hanebuechenes/synapsMEGAVCO/Hardware/production/V0.1/bom.csv

Designator | Footprint | Quantity | Value | LCSC Part #
C10, C5 | CP_Elec_6.3x7.7 | 2 | 100uF 25V
C11, C6, C_IN2 | 0805 | 3 | 10uF 25V X7R
C12, C13, C14, C17, C18, C19, C4, C7, C9, C_BOOT1, C_IN1 | 0603 | 11 | 100nF 50V X7R
C15, C16 | 0603 | 2 | 22pF
C20, C22 | 0603 | 2 | 1nF
C21, C23, C26 | 0603 | 3 | 1uF
C24, C25 | 0603 | 2 | 100nF
C_OUT1 | 0805 | 1 | 22uF 10V X5R/X7R
D1 | D_SMA | 1 | B340A
D10, D4, D5, D6, D9 | D_SOD-123 | 5 | D_Zener
D2, D3 | D_SMA | 2 | MBRA140T3G
D7, D8 | led-3mm | 2 | LED
F1, F2 | 1210 | 2 | Polyfuse
FB1, FB2 | 0603 | 2 | 120R@100MHz 2A
J1 | PinHeader_2x05_P2.54mm_Vertical | 1 | Eurorack Header
J10 | PJ301M-12 | 1 | SUB_OUT
J2 | PinHeader_2x03_P2.54mm_Vertical | 1 | ISP
J3 | PJ301M-12 | 1 | AudioOut_L
J4 | PJ301M-12 | 1 | AudioOut_R
J5 | PJ301M-12 | 1 | CV_IN
J6 | PJ301M-12 | 1 | GATE_IN
J7 | PJ301M-12 | 1 | CLOCK_IN
J8 | PJ301M-12 | 1 | SYNC_IN
J9 | PJ301M-12 | 1 | MORPH_CV
L1 | L_Coilcraft_XxL4030 | 1 | 10uH bis 15uH >1A
R1 | 0603 | 1 | 47k 1%
R10, R17, R18, R21, R6, R8, R9 | 0603 | 7 | 1k 1%
R11, R7 | RES-TH_RK09K1130A70 | 2 | RK09K1130A70 | C351173
R12, R13, R14, R15, R16, R19, R20, R5 | 0603 | 8 | 10k 1%
R2 | 0603 | 1 | 9,1k 1%
SW1 | SW_PUSH_6mm | 1 | SW_Push
U1 | SOT-23-6_L2.9-W1.6-P0.95-LS2.8-BL | 1 | TPS54302DDCR_C311983 | C311983
U3 | TQFP-32_7x7mm_P0.8mm | 1 | ATmega328P-A
U4 | SOIC-14_3.9x8.7mm_P1.27mm | 1 | MCP4922
U6 | SOIC-14_L8.7-W3.9-P1.27-LS6.0-BL | 1 | TL074
Y2 | Crystal_HC49-U_Vertical | 1 | 16MHz
