hanebuechenes/synapsMEGAVCO/Hardware/synapsMEGAVCO.kicad_pcb

## KiCad design Hardware/synapsMEGAVCO.kicad_pcb (2026-11-06)

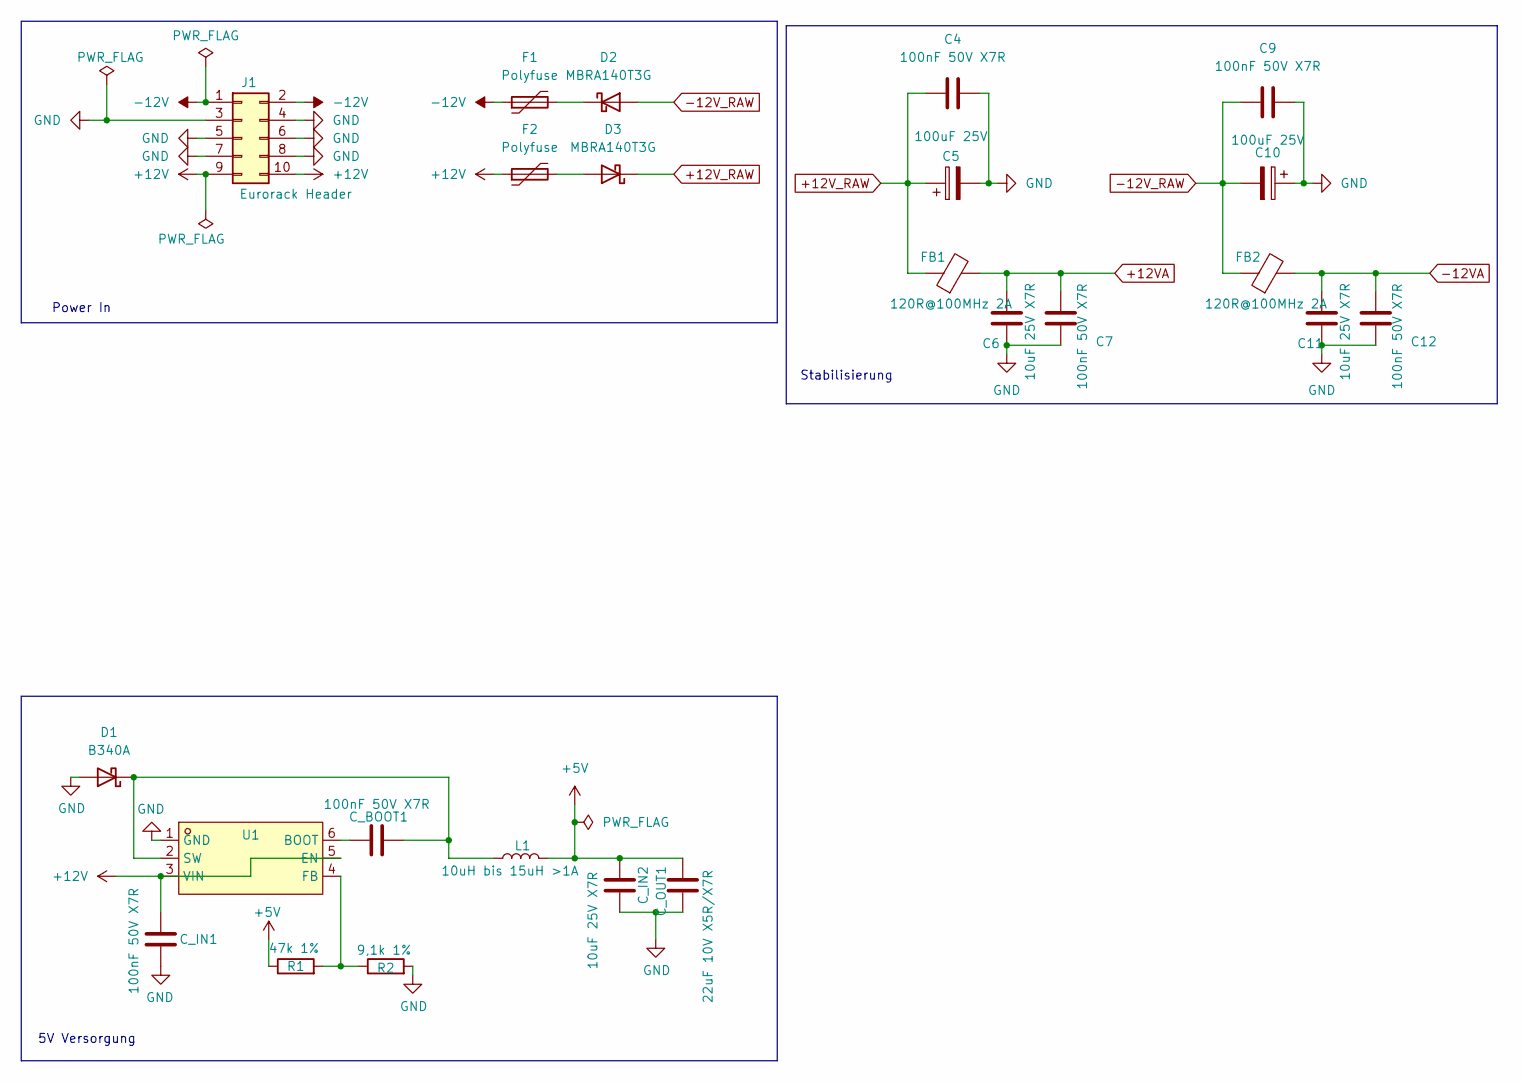
[picture p1: schematic eurorackpower.kicad_sch]

Parts:
C4, C7, C9, C12: 100nF 50V X7R; C_0603_1608Metric_Pad1.08x0.95mm_HandSolder
C5, C10: 100uF 25V; CP_Elec_6.3x7.7
C6, C11: 10uF 25V X7R; C_0805_2012Metric_Pad1.18x1.45mm_HandSolder
C_BOOT1: 100nF 50V X7R; C_0603_1608Metric_Pad1.08x0.95mm_HandSolder
C_IN1: 100nF 50V X7R; C_0603_1608Metric_Pad1.08x0.95mm_HandSolder
C_IN2: 10uF 25V X7R; C_0805_2012Metric_Pad1.18x1.45mm_HandSolder
C_OUT1: 22uF 10V X5R/X7R; C_0805_2012Metric_Pad1.18x1.45mm_HandSolder
D1: B340A; D_SMA
D2, D3: MBRA140T3G; D_SMA
F1, F2: Polyfuse; Fuse_1210_3225Metric
FB1, FB2: 120R@100MHz 2A; L_0603_1608Metric_Pad1.05x0.95mm_HandSolder
J1: Eurorack Header; PinHeader_2x05_P2.54mm_Vertical
L1: 10uH bis 15uH >1A; L_Coilcraft_XxL4030
R1: 47k 1%; R_0603_1608Metric_Pad0.98x0.95mm_HandSolder
R2: 9,1k 1%; R_0603_1608Metric_Pad0.98x0.95mm_HandSolder
U1: TPS54302DDCR_C311983; SOT-23-6_L2.9-W1.6-P0.95-LS2.8-BL; MPN TPS54302DDCR; LCSC Part C311983

Connections:
+5V: C_IN2.1, C_OUT1.1, L1.2, R1.1; also elsewhere on the board
+12V: C_IN1.1, F2.1, J1.9, J1.10, U1.3 (VIN), U1.5 (EN)
+12VA: C6.1, C7.1, FB1.2; also elsewhere on the board
+12V_RAW: C4.1, C5.1, D3.1 (K), FB1.1
-12V: F1.1, J1.1, J1.2
-12VA: C11.1, C12.1, FB2.2; also elsewhere on the board
-12V_RAW: C9.1, C10.2, D2.2 (A), FB2.1
GND: C4.2, C5.2, C6.2, C7.2, C9.2, C10.1, C11.2, C12.2, C_IN1.2, C_IN2.2, C_OUT1.2, D1.2 (A), J1.3, J1.4, J1.5, J1.6, J1.7, J1.8, R2.2, U1.1 (GND); also elsewhere on the board
unnamed: C_BOOT1.2, D1.1 (K), L1.1, U1.2 (SW)
unnamed: D2.1 (K), F1.2
unnamed: D3.2 (A), F2.2
unnamed: C_BOOT1.1, U1.6 (BOOT)
unnamed: R1.2, R2.1, U1.4 (FB)

Notes on the sheet:
5V Versorgung
Power In
Stabilisierung

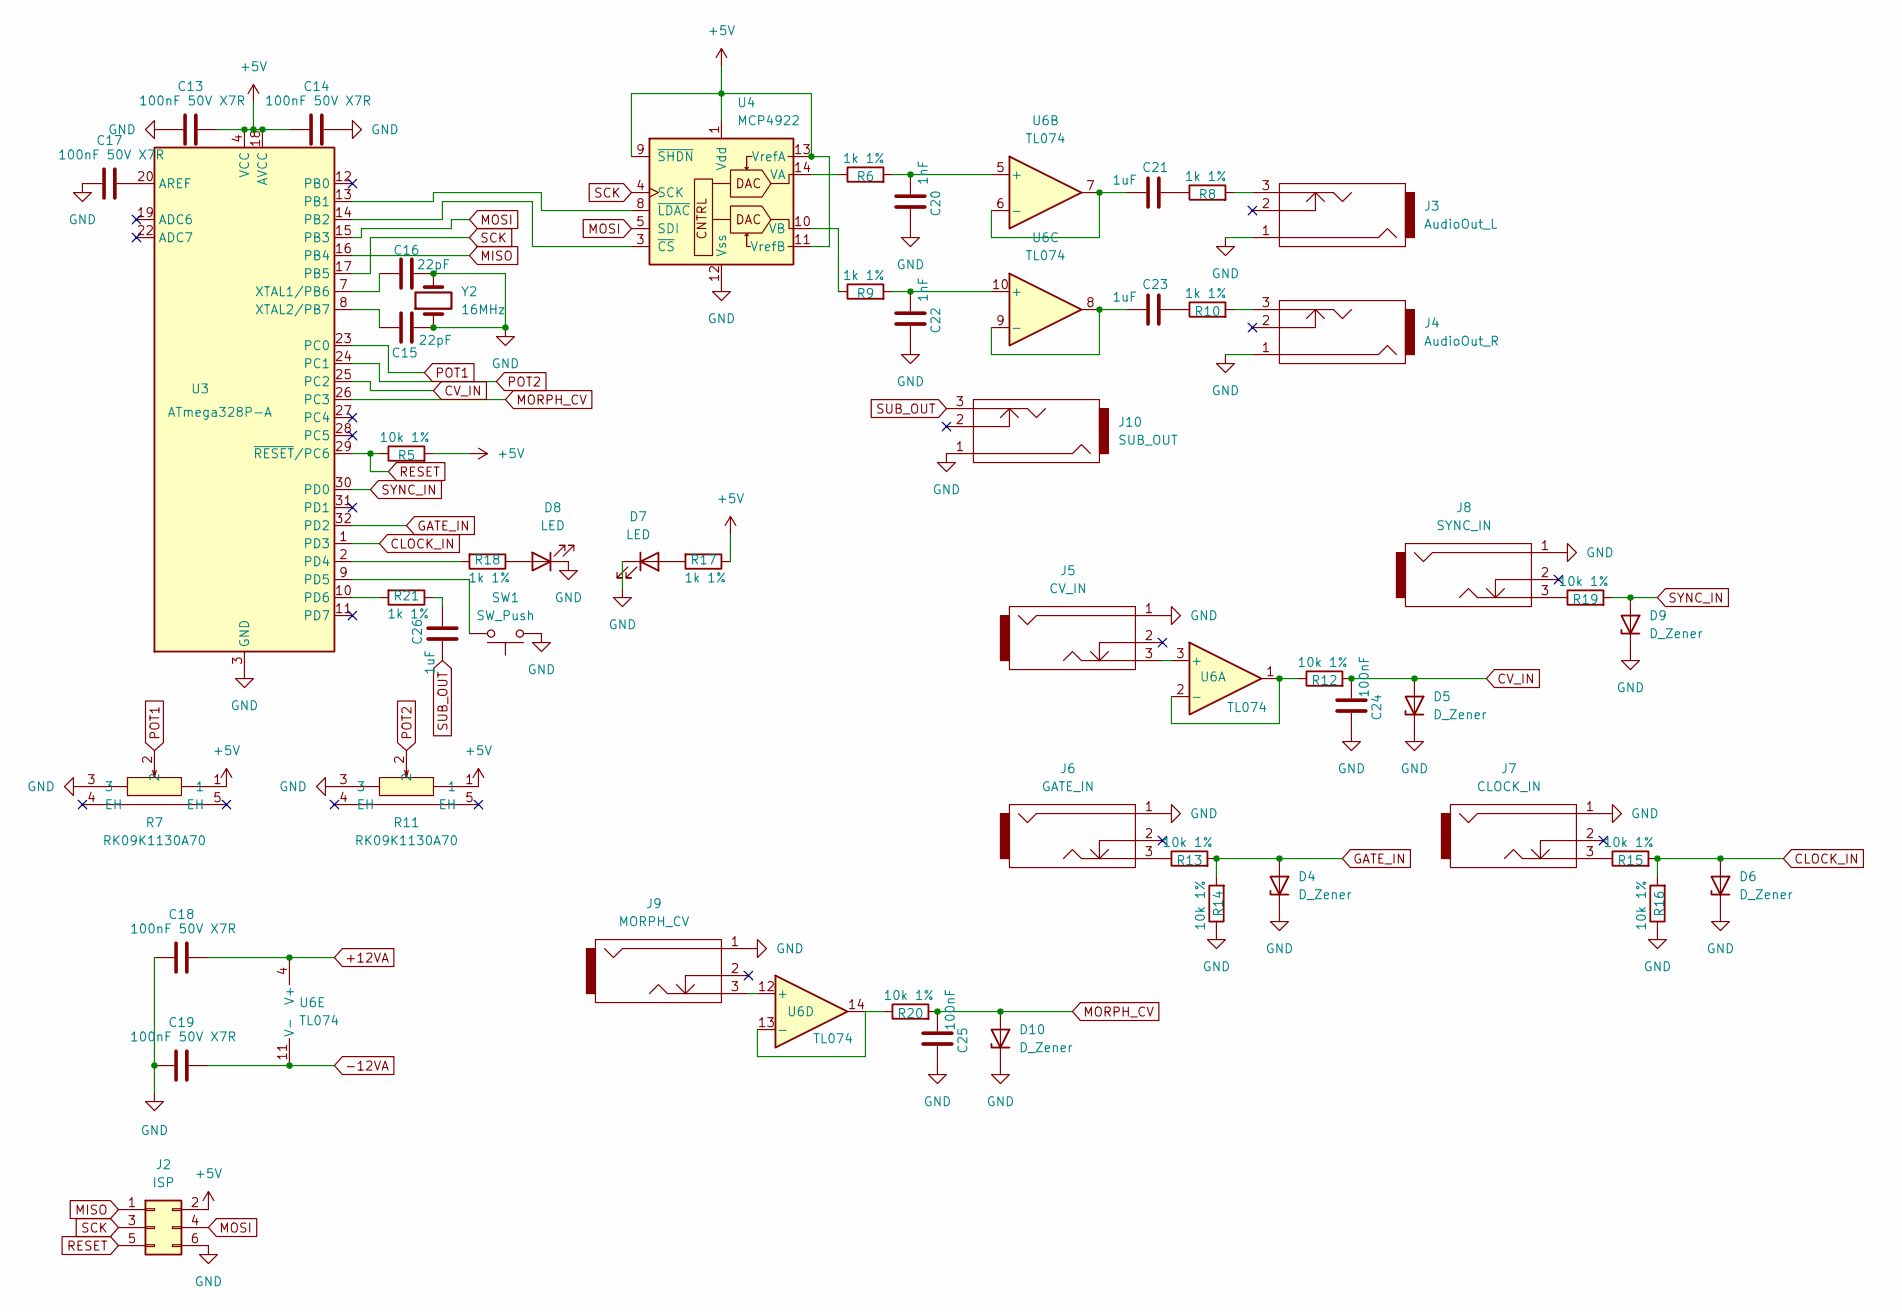
[picture p2: schematic mcu.kicad_sch]

Parts:
C13, C14, C17, C18, C19: 100nF 50V X7R; C_0603_1608Metric_Pad1.08x0.95mm_HandSolder
C15, C16: 22pF; C_0603_1608Metric_Pad1.08x0.95mm_HandSolder
C20, C22: 1nF; C_0603_1608Metric_Pad1.08x0.95mm_HandSolder
C21, C23, C26: 1uF; C_0603_1608Metric_Pad1.08x0.95mm_HandSolder
C24, C25: 100nF; C_0603_1608Metric_Pad1.08x0.95mm_HandSolder
D4, D5, D6, D9, D10: D_Zener; D_SOD-123
D7, D8: LED; led-3mm
J2: ISP; PinHeader_2x03_P2.54mm_Vertical
J3: AudioOut_L; PJ301M-12; MFG Part Number WQP-WQP518MA; Digikey Part Number N/A
J4: AudioOut_R; PJ301M-12; MFG Part Number WQP-WQP518MA; Digikey Part Number N/A
J5: CV_IN; PJ301M-12; MFG Part Number WQP-WQP518MA; Digikey Part Number N/A
J6: GATE_IN; PJ301M-12; MFG Part Number WQP-WQP518MA; Digikey Part Number N/A
J7: CLOCK_IN; PJ301M-12; MFG Part Number WQP-WQP518MA; Digikey Part Number N/A
J8: SYNC_IN; PJ301M-12; MFG Part Number WQP-WQP518MA; Digikey Part Number N/A
J9: MORPH_CV; PJ301M-12; MFG Part Number WQP-WQP518MA; Digikey Part Number N/A
J10: SUB_OUT; PJ301M-12; MFG Part Number WQP-WQP518MA; Digikey Part Number N/A
R5, R12, R13, R14, R15, R16, R19, R20: 10k 1%; R_0603_1608Metric_Pad0.98x0.95mm_HandSolder
R6, R8, R9, R10, R17, R18, R21: 1k 1%; R_0603_1608Metric_Pad0.98x0.95mm_HandSolder
R7, R11: RK09K1130A70; RES-TH_RK09K1130A70; MPN RK09K1130A70; LCSC Part C351173
SW1: SW_Push; SW_PUSH_6mm
U3: ATmega328P-A; TQFP-32_7x7mm_P0.8mm
U4: MCP4922; SOIC-14_3.9x8.7mm_P1.27mm
U6: TL074; SOIC-14_L8.7-W3.9-P1.27-LS6.0-BL
Y2: 16MHz; Crystal_HC49-U_Vertical

Connections:
+5V: C13.2, C14.1, J2.2, R5.2, R7.1, R11.1, R17.1, U3.4 (VCC), U3.6 (VCC), U3.18 (AVCC), U4.1 (Vdd), U4.9 (~SHDN), U4.11 (VrefB), U4.13 (VrefA); also elsewhere on the board
+12VA: C18.2, U6.4 (V+); also elsewhere on the board
-12VA: C19.2, U6.11 (V-); also elsewhere on the board
CLOCK_IN: D6.2 (A), R15.2, R16.2, U3.1 (PD3)
CV_IN: C24.2, D5.2 (A), R12.2, U3.25 (PC2)
GATE_IN: D4.2 (A), R13.2, R14.2, U3.32 (PD2)
GND: C13.1, C14.2, C15.2, C16.2, C17.1, C18.1, C19.1, C20.1, C22.1, C24.1, C25.1, D4.1 (K), D5.1 (K), D6.1 (K), D7.1 (K), D8.1 (K), D9.1 (K), D10.1 (K), J2.6, J3.1, J4.1, J5.1, J6.1, J7.1, J8.1, J9.1, J10.1, R7.3, R11.3, R14.1, R16.1, SW1.1, U3.3 (GND), U3.5 (GND), U3.21 (GND), U4.12 (Vss), Y2.1, Y2.2; also elsewhere on the board
MISO: J2.1, U3.16 (PB4)
MORPH_CV: C25.2, D10.2 (A), R20.2, U3.26 (PC3)
MOSI: J2.4, U3.15 (PB3), U4.5 (SDI)
unnamed: C21.1, R8.1
unnamed: C23.1, R10.1
unnamed: C26.1, R21.1
unnamed: D7.2 (A), R17.2
unnamed: D8.2 (A), R18.1
unnamed: J3.3, R8.2
unnamed: J4.3, R10.2
unnamed: J6.3, R13.1
unnamed: J7.3, R15.1
unnamed: J8.3, R19.1
unnamed: C17.2, U3.20 (AREF)
unnamed: U3.13 (PB1), U4.8 (~LDAC)
unnamed: U3.14 (PB2), U4.3 (~CS)
unnamed: R18.2, U3.2 (PD4)
unnamed: SW1.2, U3.9 (PD5)
unnamed: R21.2, U3.10 (PD6)
unnamed: C16.1, U3.7 (XTAL1/PB6)
unnamed: C15.1, U3.8 (XTAL2/PB7)
unnamed: R6.1, U4.14 (VA)
unnamed: R9.1, U4.10 (VB)
unnamed: J5.3, U6.3 (+)
unnamed: R12.1, U6.1, U6.2 (-)
unnamed: C20.2, R6.2, U6.5 (+)
unnamed: C21.2, U6.6 (-), U6.7
unnamed: C22.2, R9.2, U6.10 (+)
unnamed: C23.2, U6.8, U6.9 (-)
unnamed: J9.3, U6.12 (+)
unnamed: R20.1, U6.13 (-), U6.14
POT1: R7.2, U3.23 (PC0)
POT2: R11.2, U3.24 (PC1)
RESET: J2.5, R5.1, U3.29 (~RESET/PC6)
SCK: J2.3, U3.17 (PB5), U4.4 (SCK)
SUB_OUT: C26.2, J10.3
SYNC_IN: D9.2 (A), R19.2, U3.30 (PD0)

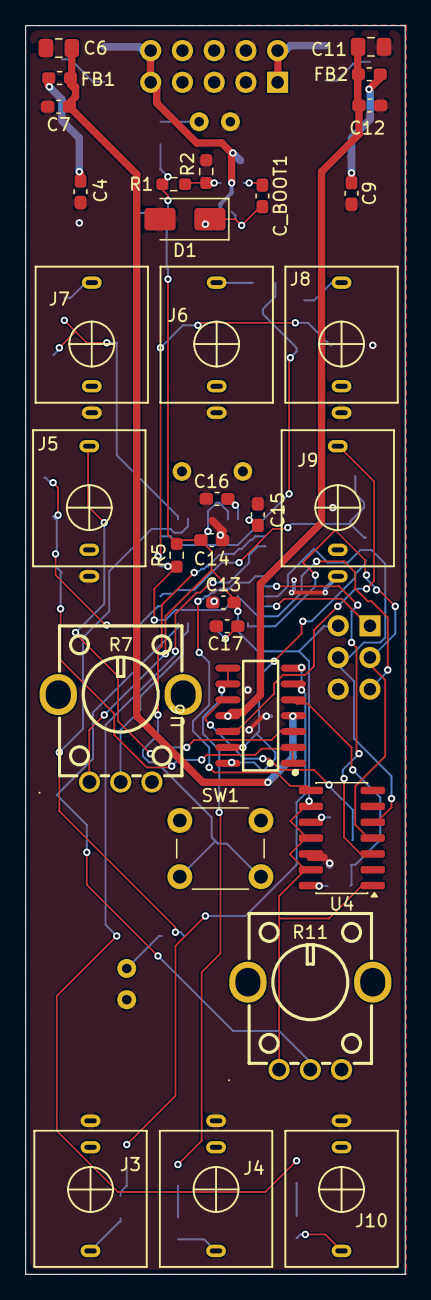
[picture p3: board synapsMEGAVCO.kicad_pcb from above]

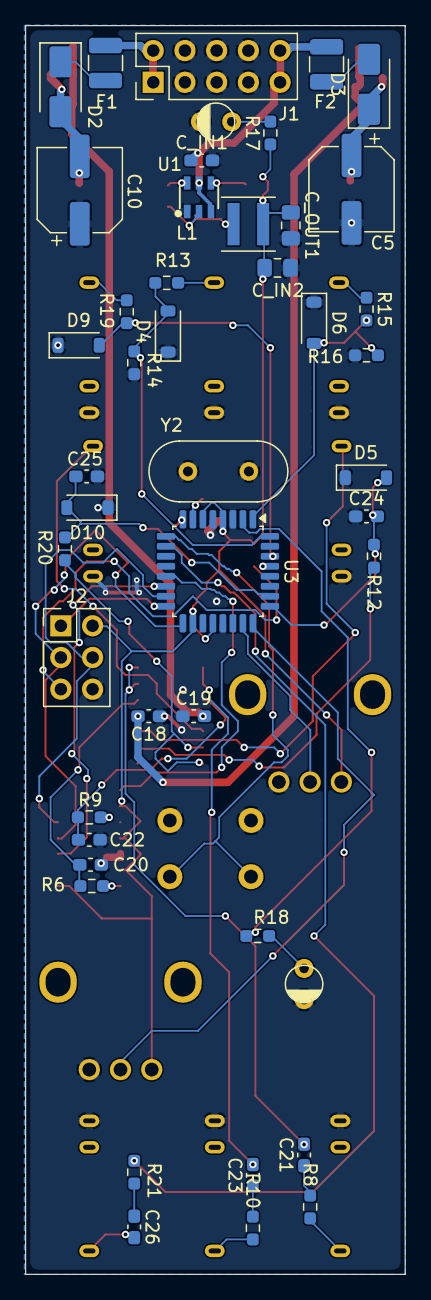
[picture p4: board synapsMEGAVCO.kicad_pcb from below]

Board: 2 copper layers, 30.4 x 100.0 mm, 76 parts (45 on the bottom side), 53 nets.
